FidelDworp/SJALAY-YSERMONDE/Verwarming_in_de_Sjalay.pdf

# 🏠 Verwarming in de Sjalay

Korte handleiding voor familie en huurders

De oude WOLF-thermostaat aan de muur naast de keuken moet ALTIJD AAN blijven staan. Niet uitzetten, niet verdraaien.

### In 5 stappen

### De thermostaat (niet aanraken)

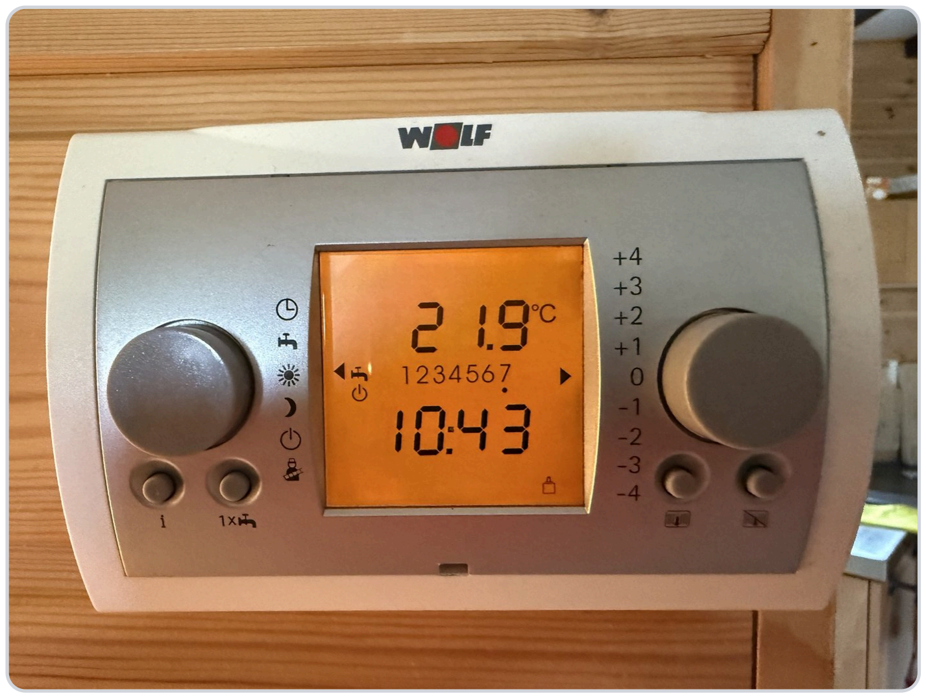
[picture p1: figure]

WOLF-thermostaat in de living, naast de keuken

Linkse knop | Het pijltje links op het display staat naast het zonnetje. Het kraantje (warm water) en het "aan"-symbool zijn zichtbaar.
Rechtse knop | Het pijltje rechts staat naast de schaal +4 … 0 … −4. Dit is de maximale kamertemperatuur: naast 0 is het max. 20 °C, elke stap omhoog is +1 °C (tot +4 = 24 °C), elke stap omlaag −1 °C (tot −4 = 16 °C). Aanbevolen: 20–22 °C en er niet meer aan komen.

Thermostaat laten staan. Hij is het "brein" van de ketel. Zonder hem draait de verwarming niet. Zie de foto hieronder.

1

Open de app. Verbind met het wifi van de Sjalay: naam sjalayke , wachtwoord sjalayke-2026 . Open daarna in de browser van je telefoon http://sjalay.local/ Lukt dat niet? Probeer http://192.168.50.10/

2

🔥 Verwarming: schuif de balk onder het vlammetje op de gewenste temperatuur. 20– 22 °C is ideaal.

3

🚿 Warm water: schuif de balk onder het douche-icoon op de gewenste temperatuur van de boiler. Dit staat los van de verwarming.

4

👋 Bij vertrek: zet het warm water minstens een halve dag vooraf op 10 °C. Raak verder niets aan, ook de thermostaat niet.

5

# De app uitgelegd

Wat je ziet op de pagina http://sjalay.local/

### 1 Lampen. Eén tegel per lamp (Ronde papierlamp, Hoge

lamp, Bib kast, Kerstverlichting). Tik om aan of uit te zetten. Gekleurd = aan, wit = uit. Sommige tegels schakelen ook een stopcontact mee.

2 Bed-modus (nachtmodus) ️: de eerste lamp blijft uit. Donkerblauw = aan.

### 3 Eerste lamp automatisch of handmatig. 🔄 =

automatisch (gaat aan bij beweging als het donker is). ✋ (groen) = handmatig: blijft zoals jij het zet. Tik om te wisselen.

4 Kleur van de lampen: tik en kies een kleur.

### 5 Verwarming 🔥. Groot: de gemeten temperatuur in

huis. Tussen haakjes (→ 20°): de temperatuur waarop geregeld wordt. Die kan iets hoger zijn dan jouw keuze om vochtproblemen te voorkomen. Dat is normaal.

### 6 Schuifbalk verwarming (5–30 °C): schuif naar de

gewenste temperatuur. 20–22 °C is ideaal.

### 7 Warm water 🚿. Groot: de temperatuur van de

boiler. Tussen haakjes het doel.

### 8 Schuifbalk warm water (10–60 °C). Op 10 °C blijft de

boiler uit. Dit staat los van de verwarming.

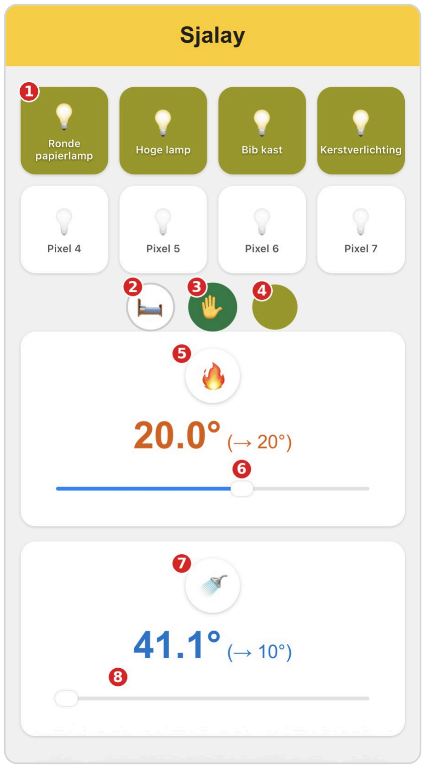
[picture p2: figure]

Rode cirkel rond 🔥 of 🚿 = de verwarming of de boilerverwarming is nu actief; wit = rust. Een gedimde 🌙-tegel betekent dat de eerste lamp vergrendeld is door de bed-modus. Het ⚙️-icoon

### Goed om te weten

De verwarming reageert niet onmiddellijk; het huis warmt geleidelijk op.
Je hoeft nooit "handmatig" te schakelen: de controller regelt automatisch.
Zonder stroom op de controller (de kast in de kelder) draait de verwarming niet. De ketel blijft dan veilig uit; de vorstbeveiliging blijft werken.

### Werkt iets niet?

1. Staat het wifi van de Sjalay aan en ben je ermee verbonden?
2. Staat de WOLF-thermostaat nog aan (display brandt)?
3. Laadt de pagina niet? Probeer http://192.168.50.10/ , wacht even en probeer opnieuw.
4. Blijft het mislukken? Laat het Filip weten.

# Terugdraaien naar de oude toestand

Alleen gebruiken als de controller definitief niet meer werkt

Veiligheid: zorg dat de 230 V-voeding van de verwarming UIT staat voor je iets aanraakt: grijs bakje op de muur, rode knop indrukken.

### 1. In de ketelkast

### 2. In de living, aan de WOLF-thermostaat

Nu werkt alles weer als origineel.

Sjalay Controller · handleiding versie 25 oktober 2026

Je ziet in de kast, boven de gekleurde blokjes, een witte tape met 2 draadjes en een ijzeren brugje.

1

Neem een kleine platte (−) schroevendraaier en schroef de draadjes in het gele en het blauwe blokje los. Vervang ze:
- gele blokje: het brugje (of een kortsluitdraadje)
- blauwe blokje: het rode en het witte draadje (de oorspronkelijke voeler). Geen polariteit van belang.

2

3 Schroef alle 4 schroefjes weer vast.

4 Doe het deksel dicht en schroef het vast met 2 kruisschroeven (+).

5 Zet de stroom van de verwarming weer aan: groene knop (grijze bakje).

1 Druk de rechtse ronde knop in: "WEERGAVE".

### 2 Draai 3 kliks naar rechts: "VAKMAN". Indrukken: "CODE NR."

3 Draai naar "0", dan 1 klik rechts: "1". Indrukken: "INSTALLATIE".

4 Draai 1 klik rechts: "KETEL". Indrukken: "HG00".

5 Draai naar rechts tot "HG24" verschijnt ("3"). Indrukken: "3" knippert.

6 Draai naar links tot "1". Indrukken: "1" wordt gekozen.
