FidelDworp/SJALAY-YSERMONDE/(commit log)

2026-09-25 Revise README with project details and setup guide
    Updated README to include detailed project information, objectives, hardware architecture, and setup instructions for remote control of WOLF boiler and SWW boiler using ESP32-C6.
2026-09-26 Expand README with SJALAY controller details
    Added detailed specifications and plans for the SJALAY controller, including features, platform requirements, web UI design, sensor integration, and Google Sheets logging.
2026-09-28 Update file header comment for clarity
    // v0.10 (28sep26): Optionele koppeling met Shelly-slimme-stopcontacten per pixel.
    // Settings: extra veld per pixel "ip:naam,ip:naam" (max 3 Shelly's
    // per pixel). Bij elke effectieve AAN/UIT-wissel van een pixel
    // (rand-detectie, niet elke lus) stuurt de sketch een korte lokale
    // HTTP-GET naar elk gekoppeld IP (http://ip/relay/0?turn=on|off,
    // compatibel met Shelly Gen1/2/3, geen cloud/account nodig). Op de
    // statuspagina staat naast elke pixel de naam van de gekoppelde
    // stopcontacten. Geen retry/terugkoppeling (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
2026-09-28 Document SJALAY sketch implementation details
    Added detailed implementation information for SJALAY sketch, including file and board settings, pin usage, web interface endpoints, settings page fields, heating logic, powerpixels, Google Sheets logging, and known issues.
2026-09-28 Revise LAN settings and improve README formatting
    Updated LAN settings and documentation for Raspberry Pi and Tailscale integration. Fixed formatting issues in the README.
2026-09-28 Update README with E1 bridge removal instructions
    Added important notes regarding the removal of the existing bridge over E1 before connecting the relay, including safety reminders and open points for verification.
2026-09-29 Update print statement from 'Hello' to 'Goodbye'
2026-09-29 Update README for version 0.12 features and changes
    Updated version number to v0.12 and modified various sections to reflect new features and changes. Added a simple landing page for guests and moved the status page to a new endpoint.
2026-09-29 Revise README for v0.12 updates and landing page
    Updated the README.md to reflect changes in version 0.12, including the introduction of a simple landing page for guests and the relocation of the technical status page.
2026-09-29 Update README for v0.13 changes and improvements
    Updated version number to v0.13 and refined landing page features based on feedback.
2026-09-29 Update SJALAY_CONTROLLER to version 0.13
    Updated version number to v0.13 and made various improvements to the landing page UI and functionality for better user experience.
2026-09-29 Update README for v0.15 changes and features
    Updated version number to v0.15 and added details about bed mode functionality and mDNS/Bonjour support.
2026-09-29 Update SJALAY_CONTROLLER to version 0.15 with bed mode
    Added bed mode to landing page to prevent automatic activation of pixel 0 at night. Updated version to 0.15.
    [ESP32-C6_SJALAY_CONTROLLER.ino]
2026-09-30 Update README with latest project details
    Updated the README to reflect the latest changes in the Sjalay Controller project, including updates on the SWW relay and sensor configurations.
2026-09-30 Update README with preparation and materials sections
    Added preparation and materials checklist for upcoming tasks.
2026-09-30 Update to v0.16 with Pixel 0 toggle button
    Added a new button on the landing page to toggle Pixel 0 (MOV1) back to AUTO from the landing page. Updated version to v0.16 and modified related UI elements.
2026-09-30 Revise README for updates on features and configurations
    Updated the README with new status and feature details, including changes to the landing page, network configuration, and sensor integration.
2026-10-24 Update README with new measurement tasks and date
    Updated the last modified date and added new measurement tasks for the DHT22 sensor.
2026-10-25 Add instructions for reverting heating system settings
    Added instructions for reverting heating system to original state for non-technical users, including detailed steps and safety precautions.
2026-10-25 Update fmt.Println message from 'Hello' to 'Goodbye'
2026-10-25 Revise power supply details and testing instructions
    Updated power supply requirements and testing notes for the controller and relay module in the README.
2026-10-28 Upgrade SJALAY CONTROLLER to version 1.6
    Updated version from 1.4 to 1.6 with various enhancements including DHT22 power cycle management and improved error handling in Google Sheets POST requests.
2026-10-29 Update README with new date and DHT22 power research
    Updated the last updated date and added a section on power research for DHT22.
2026-11-02 Update SJALAY version to 1.8 with new setpoints
    Updated version to 1.8 and added minimum setpoints for heating and boiler. Adjusted constraints for setpoints based on new minimum values.
2026-11-06 Repo herschikt: sketchmap ESP32-C6_SJALAY_CONTROLLER/, GoogleScript/, docs/
    Claude-Session: https://claude.ai/code/session_017ReuEuURXLPpgPzmTtYrFf
2026-11-06 partitions.csv toegevoegd (16 MB: 2 x 6 MB app voor OTA, zoals in de sketchkop)
    Identiek aan de andere Zarlar-controllers.
    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
2026-11-07 bin/: gecompileerde .bin van de huidige sketch, klaar voor /update
    Gecompileerd in de Claude-sessie met ESP32-core 3.3.12 en de nieuwste
    bibliotheken. Alleen de laatste versie staat in bin/.
    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
2026-11-07 docs: overdracht voor een nieuw gesprek met Claude (stand 7/11)
    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
2026-11-09 Overdracht: ROOM-versies voor de Sjalay-goodies nu v3.6/v3.7 (planning 9/11)
    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
2026-11-09 Plan Stap D: SCD41 in de Sjalay (CO2 + reserve vocht/dauwpunt), na ROOM v3.4.3-test
    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
2026-11-09 Stap D: plan SCD41 goedgekeurd — v1.9/v1.10/v1.11, keys H en I, kolommen AI/AJ
    Claude-Session: https://claude.ai/code/session_017ReuExJnvHTodoX223bpZc
2026-11-09 v1.9: USB-pinnen IO12/IO13 vrij (CDC On Boot uit), stap 1 van 3 voor de SCD41
    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
2026-11-11 Plan Stap E: lessen uit ROOM v3.4.4/v3.4.5 (eigen DHT22-uitlezing, NVS); power cycle blijft nodig
    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
2026-11-11 v1.9 via OTA geflasht (11/11), OTA-les genoteerd
    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
2026-11-11 Buildmap van arduino-cli uit de repo (hoort niet in git) + .gitignore
    Claude-Session: https://claude.ai/code/session_017ReuEwqrwD9jUZHSBwaDMS
